SomeLucky1/CoffeeHat/Hardware/GaggiaBoard_V3/KiCad/Project/GaggiaBoard_V3.kicad_pcb

## KiCad design Hardware/GaggiaBoard_V3/KiCad/Project/GaggiaBoard_V3.kicad_pcb (2023-09-10)

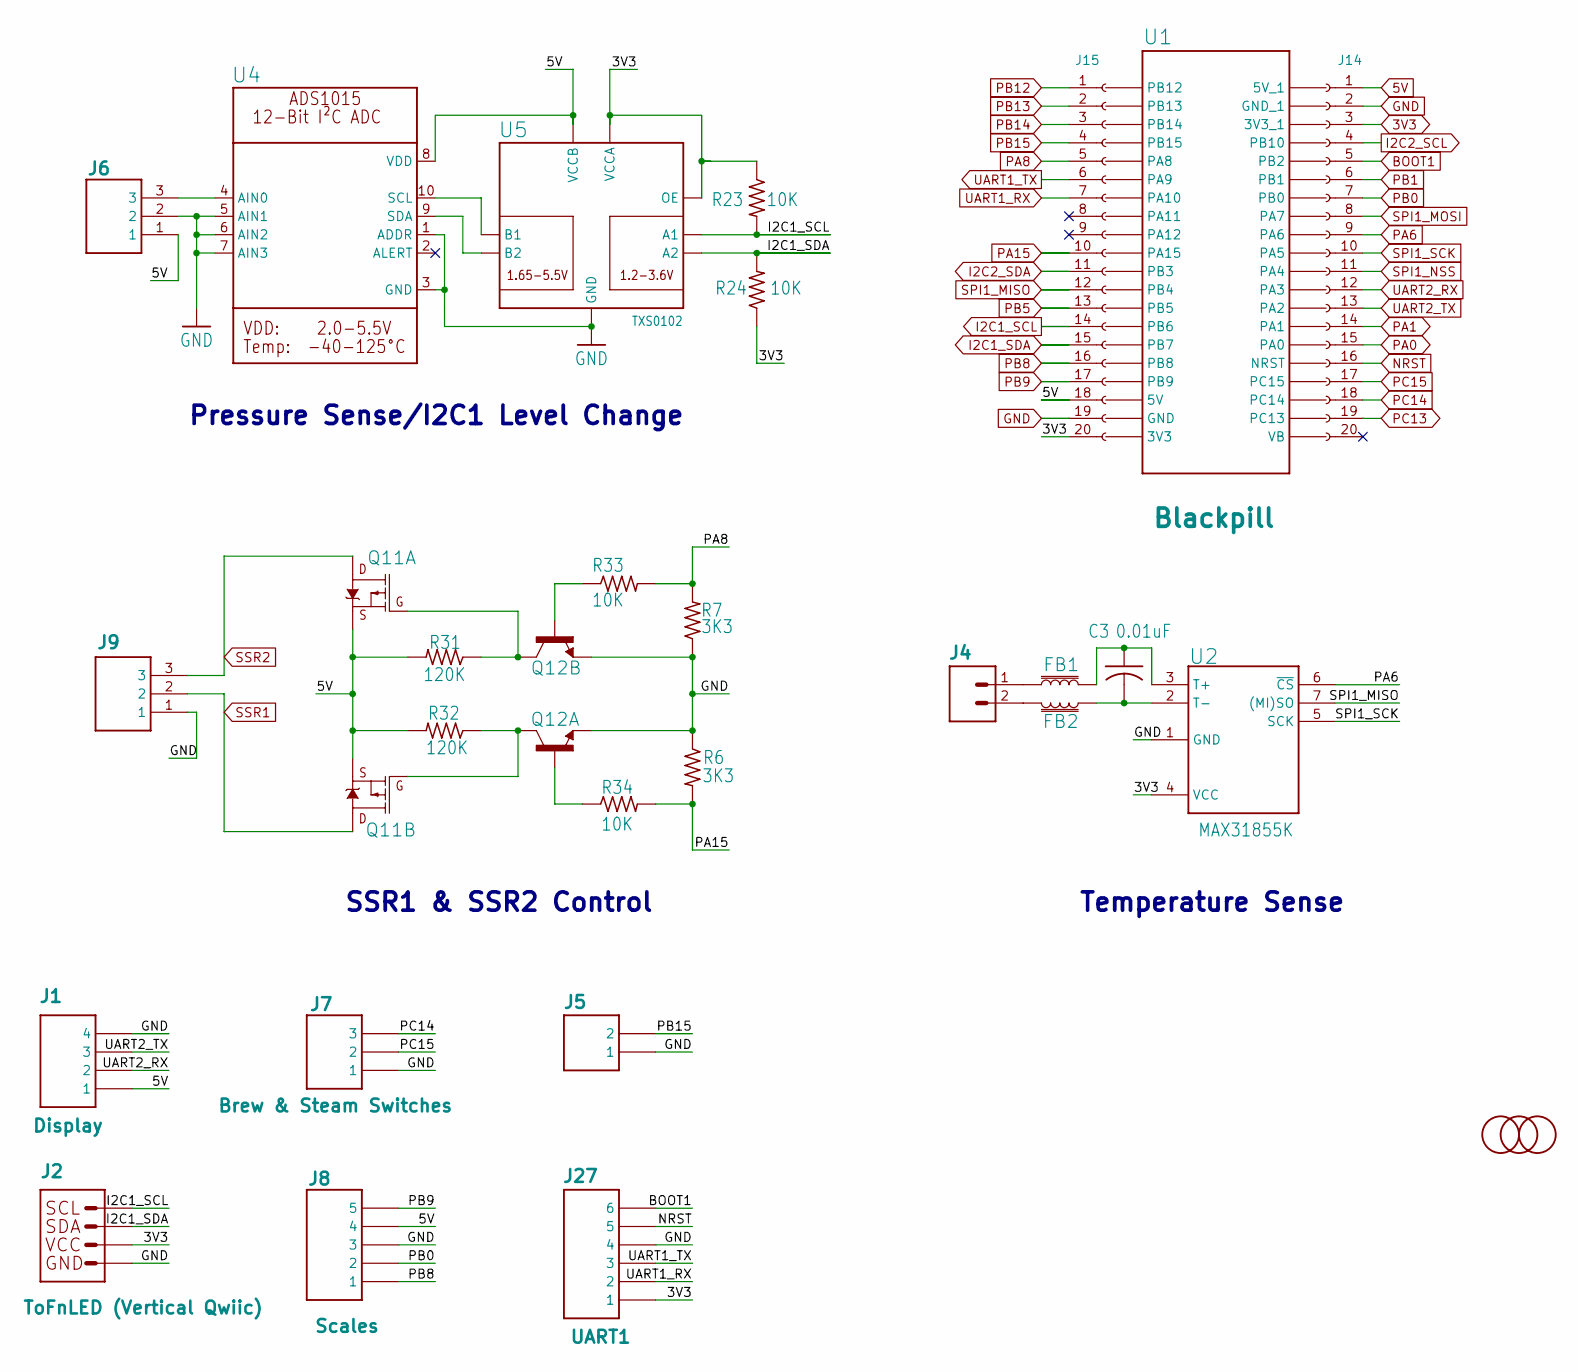
[picture p7: schematic GaggiaBoard_V3_1.kicad_sch, GaggiaBoard V3]

Parts:
C3: 0.01uF; C0603; LCSC C100042
FB1, FB2: FERRITE_BEAD-0603-470Ω-100MHZ-1A-200MILIΩ; 0603; LCSC C883591
J1: Display; B4B-PH-K-S; LCSC C131334
J2: ToFnLED (Vertical Qwiic); JST04_1MM_VERT; LCSC C160390
J4: TC Sensor; SCREWTERMINAL-3.5MM-2-NS; LCSC C474892
J5: 2PIN; B2B-PH-K-S; LCSC C131337
J6: Pressure TD; B3B-PH-K-S; LCSC C131339
J7: Brew & Steam Switches; B3B-PH-K-S; LCSC C131339
J8: Scales; B5B-PH-K-S; LCSC C157993
J9: SSR; B3B-PH-K-S; LCSC C131339
J14, J15: 1x20 Female Header 2.54mm; 1x20_P2.54mm_Female_Vertical
J27: UART1; B6B-PH-K-S; LCSC C131342
MARK1, MARK2, MARK5: FIDUCIAL; FIDUCIAL_1MM
Q11: MOSFET_PCH_DUAL-DMP2240UDM; SOT26; LCSC C397948
Q12: TRANS_NPN_DUAL-MBT3904DW1T1; SC70-6; LCSC C896759
R6, R7: 3K3; R0603; LCSC C114432
R23, R24, R33, R34: 10K; R0603; LCSC C98220
R31, R32: 120K; R0603; LCSC C114607
U1: Blackpill; BLACKPILL
U2: MAX31855K; SO08; LCSC C52028
U4: ADC_ADS1015; MSOP10; LCSC C193969
U5: TXS0102; VFSOP-8; LCSC C53434

Connections:
3V3: J2.2, J14.3, J15.20, J27.1, R23.1, R24.1, U2.4 (VCC), U5.P$3 (VCCA), U5.P$6 (OE); also elsewhere on the board
5V: J1.1, J6.1, J8.4, J14.1, J15.18, Q11.S1 (S), Q11.S2 (S), R31.2, R32.2, U4.8 (VDD), U5.P$7 (VCCB); also elsewhere on the board
BOOT1: J14.5, J27.6
GND: J1.4, J2.1, J5.1, J6.2, J7.1, J8.3, J9.1, J14.2, J15.19, J27.4, Q12.1 (E), Q12.4 (E), R6.1, R7.1, U2.1 (GND), U4.1 (ADDR), U4.3 (GND), U4.5 (AIN1), U4.6 (AIN2), U4.7 (AIN3), U5.P$2 (GND); also elsewhere on the board
I2C1_SCL: J2.4, J15.14, R23.2, U5.P$5 (A1)
I2C1_SDA: J2.3, J15.15, R24.2, U5.P$4 (A2)
I2C2_SCL: J14.4
I2C2_SDA: J15.11
NRST: J14.16, J27.5
unnamed: FB1.1, J4.1
unnamed: FB2.1, J4.2
unnamed: Q11.G1 (G), Q12.6 (C), R31.1
unnamed: Q11.G2 (G), Q12.3 (C), R32.1
unnamed: Q12.5 (B), R34.1
unnamed: Q12.2 (B), R33.1
unnamed: C3.1, FB1.2, U2.3 (T+)
unnamed: C3.2, FB2.2, U2.2 (T-)
unnamed: J6.3, U4.4 (AIN0)
unnamed: U4.10 (SCL), U5.P$8 (B1)
unnamed: U4.9 (SDA), U5.P$1 (B2)
PA0: J14.15; also elsewhere on the board
PA1: J14.14; also elsewhere on the board
PA6: J14.9, U2.6 (~CS)
PA8: J15.5, R7.2, R33.2
PA15: J15.10, R6.2, R34.2
PB0: J8.2, J14.7
PB1: J14.6
PB5: J15.13
PB8: J8.1, J15.16
PB9: J8.5, J15.17
PB12: J15.1
PB13: J15.2
PB14: J15.3
PB15: J5.2, J15.4
PC13: J14.19; also elsewhere on the board
PC14: J7.3, J14.18
PC15: J7.2, J14.17
SPI1_MISO: J15.12, U2.7 ((MI)SO)
SPI1_MOSI: J14.8
SPI1_NSS: J14.11
SPI1_SCK: J14.10, U2.5 (SCK)
SSR1: J9.2, Q11.D2 (D)
SSR2: J9.3, Q11.D1 (D)
UART1_RX: J15.7, J27.2
UART1_TX: J15.6, J27.3
UART2_RX: J1.2, J14.12
UART2_TX: J1.3, J14.13

Notes on the sheet:
Pressure Sense/I2C1 Level Change
SSR1 & SSR2 Control
Temperature Sense

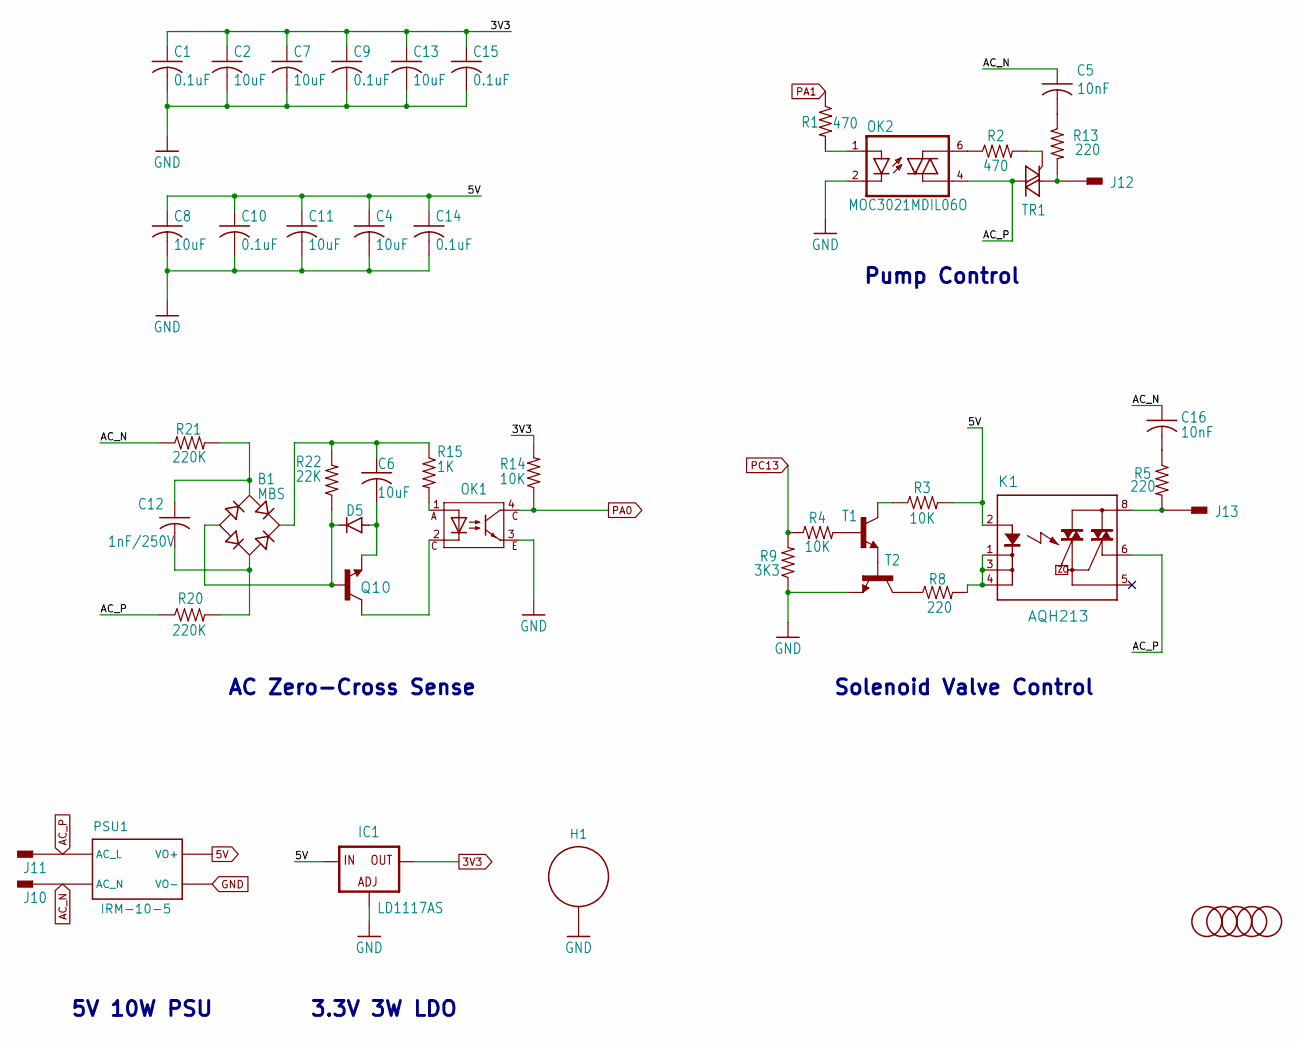
[picture p8: schematic GaggiaBoard_V3_2.kicad_sch]

Parts:
B1: MBS; SOIC-4; LCSC C2487
C1, C9, C10, C14, C15: 0.1uF; C0603; LCSC C1591
C2, C4, C6, C7, C8, C11, C13: 10uF; C0603; LCSC C86275
C5, C16: 10nF; C1206; LCSC C107192
C12: 1nF/250V; C0603; LCSC C277510
D5: 1N4007; DO214AC; LCSC C727081
H1: STANDOFF_ELECTRICAL; STANDOFF-ELECTRICAL
IC1: LD1117AS; SOT223; LCSC C26537
J10, J11, J12, J13: PIN262409-1; 62409-1; LCSC C86495
K1: AQH213; DIL07; LCSC C719560
MARK3, MARK4, MARK6, MARK7, MARK8: FIDUCIAL; FIDUCIAL_1MM
OK1: WL-OCPT_SERIES_101X; WL-OCPT_LSOP4; LCSC C141610
OK2: MOC3021MDIL06O; DIL06O; LCSC C5242
PSU1: IRM-10-5; IRM-10; LCSC C2857903
Q10: TRANS_NPN-MMBT2222AL; SOT23-3; LCSC C82460
R1, R2: 470; R0603; LCSC C114669
R3, R4, R14: 10K; R0603; LCSC C98220
R5, R13: 220; R2512; LCSC C877859
R8: 220; R0603; LCSC C107696
R9: 3K3; R0603; LCSC C114432
R15: 1K; R0603; LCSC C22548
R20, R21: 220K; R1206; LCSC C130275
R22: 22K; R0603; LCSC C114065
T1, T2: -NPN-SOT23-BEC; SOT23-BEC; LCSC C82460
TR1: Z0107MNSOT-223; SOT223; LCSC C71218

Connections:
3V3: C1.1, C2.1, C7.1, C9.1, C13.1, C15.1, IC1.4 (OUT), R14.2; also elsewhere on the board
5V: C4.1, C8.1, C10.1, C11.1, C14.1, IC1.3 (IN), K1.2 (A), PSU1.+V (VO+), R3.2; also elsewhere on the board
AC_N: C5.1, C16.1, J10.A1 (1), J10.A2 (1), PSU1.AC/N (AC_N), R21.1
AC_P: J11.A1 (1), J11.A2 (1), K1.6 (DS3), OK2.4 (A1), PSU1.AC/L (AC_L), R20.1, TR1.2 (A2), TR1.4 (A2)
GND: C1.2, C2.2, C4.2, C7.2, C8.2, C9.2, C10.2, C11.2, C13.2, C14.2, C15.2, H1.P1, IC1.1 (ADJ), OK1.3, OK2.2 (C), PSU1.-V (VO-), R9.1, T2.E; also elsewhere on the board
unnamed: B1.~1 (AC1), C12.2, R20.2
unnamed: B1.~2 (AC2), C12.1, R21.2
unnamed: B1.+, C6.1, R15.1, R22.2
unnamed: C5.2, R13.1
unnamed: C16.2, R5.1
unnamed: J13.A1 (1), J13.A2 (1), K1.8 (DS1), R5.2
unnamed: K1.1 (K), K1.3 (K1), K1.4 (K2), R8.2
unnamed: OK1.1, R15.2
unnamed: OK2.6 (A2), R2.1
unnamed: OK2.1 (A), R1.2
unnamed: B1.-, D5.C, Q10.1 (B), R22.1
unnamed: OK1.2, Q10.3 (C)
unnamed: C6.2, D5.A, Q10.2 (E)
unnamed: R3.1, T1.C
unnamed: R4.2, T1.B
unnamed: R8.1, T2.C
unnamed: T1.E, T2.B
unnamed: J12.A1 (1), J12.A2 (1), R13.2, TR1.1 (A1)
unnamed: R2.2, TR1.3 (G)
PA0: OK1.4, R14.1; also elsewhere on the board
PA1: R1.1; also elsewhere on the board
PC13: R4.1, R9.2; also elsewhere on the board

Notes on the sheet:
5V 10W PSU
AC Zero-Cross Sense
Solenoid Valve Control
Pump Control
3.3V 3W LDO

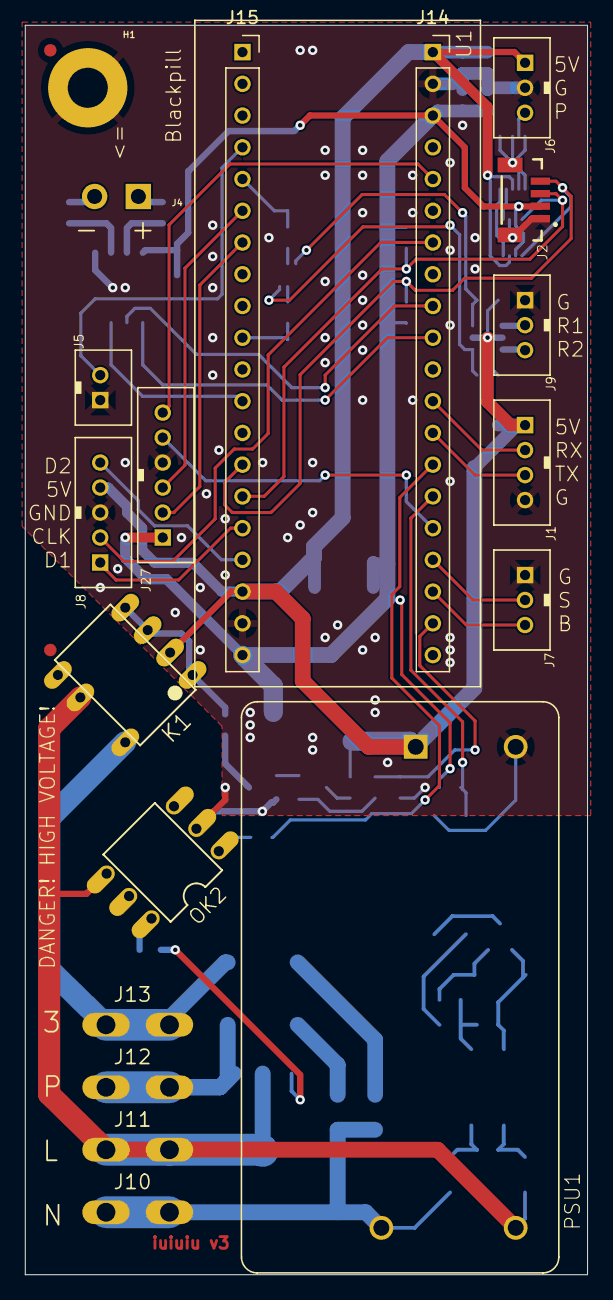
[picture p9: board GaggiaBoard_V3.kicad_pcb from above]

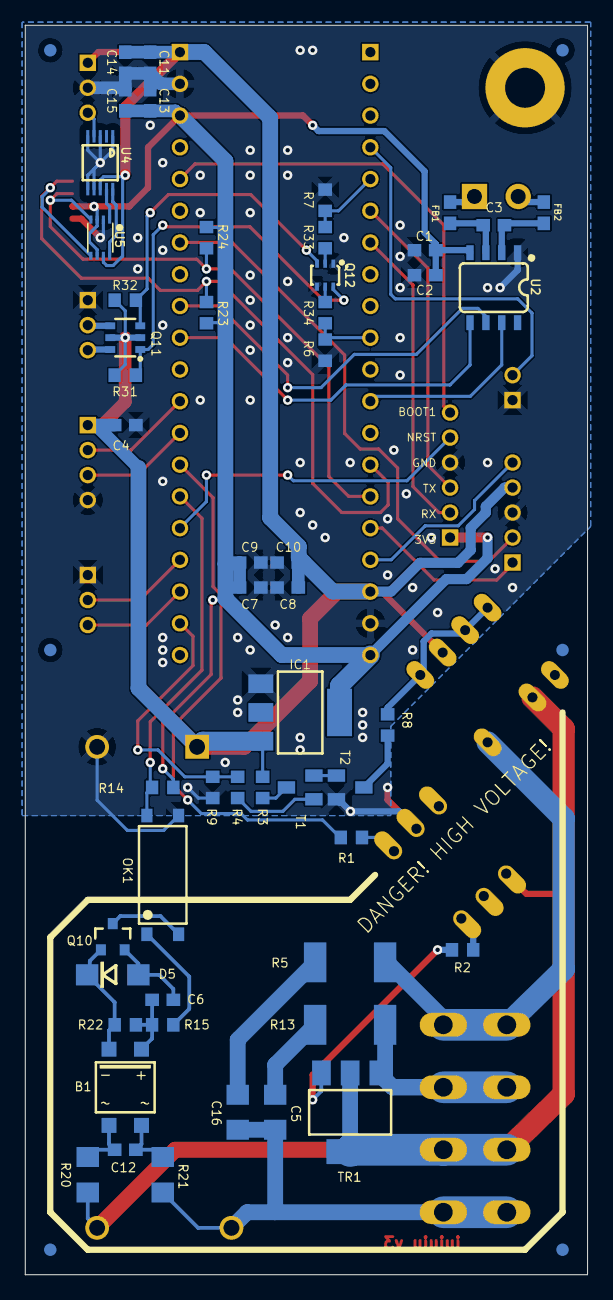
[picture p10: board GaggiaBoard_V3.kicad_pcb from below]

Board: 2 copper layers, 45.0 x 100.0 mm, 80 parts (58 on the bottom side), 59 nets.
