SomeLucky1/CoffeeHat/(commit log)

2023-09-08 Adding converted KiCad project assets
    [GaggiaBoard_V3.kicad_pcb, GaggiaBoard_V3.kicad_sch, GaggiaBoard_V3_1.kicad_sch, GaggiaBoard_V3_2.kicad_sch]
2023-09-10 KiCad project and model updates
    [GaggiaBoard_V3.kicad_pcb, GaggiaBoard_V3_1.kicad_sch]
